Elmue/IR-Computer-Remote-Control/README.md

# IR-Computer-Remote-Control
Remote Control a Computer with Infrared

Remote_Controls

Teensy_Receiver

For a detailed description please see:
https://netcult.ch/elmue/IR-Computer-Remote-Control/
